HelloWorldTeraByte/MOSSbp-Jetson-Nano-Board/README.md

# MOSSbp-Jetson-Nano-Board
MOSSbp(Multi-material Open Source Secure Bio Printer) is an IoT connected bio printer. This is a daughter board for the jetson nano.
