HelloWorldTeraByte/MOSSbp-Jetson-Nano-Board/MOSSbp_Jetson_Nano_Board/MOSSbp_Jetson_Nano_Board.kicad_pcb

## KiCad design MOSSbp_Jetson_Nano_Board/MOSSbp_Jetson_Nano_Board.kicad_pcb (2020-01-27)

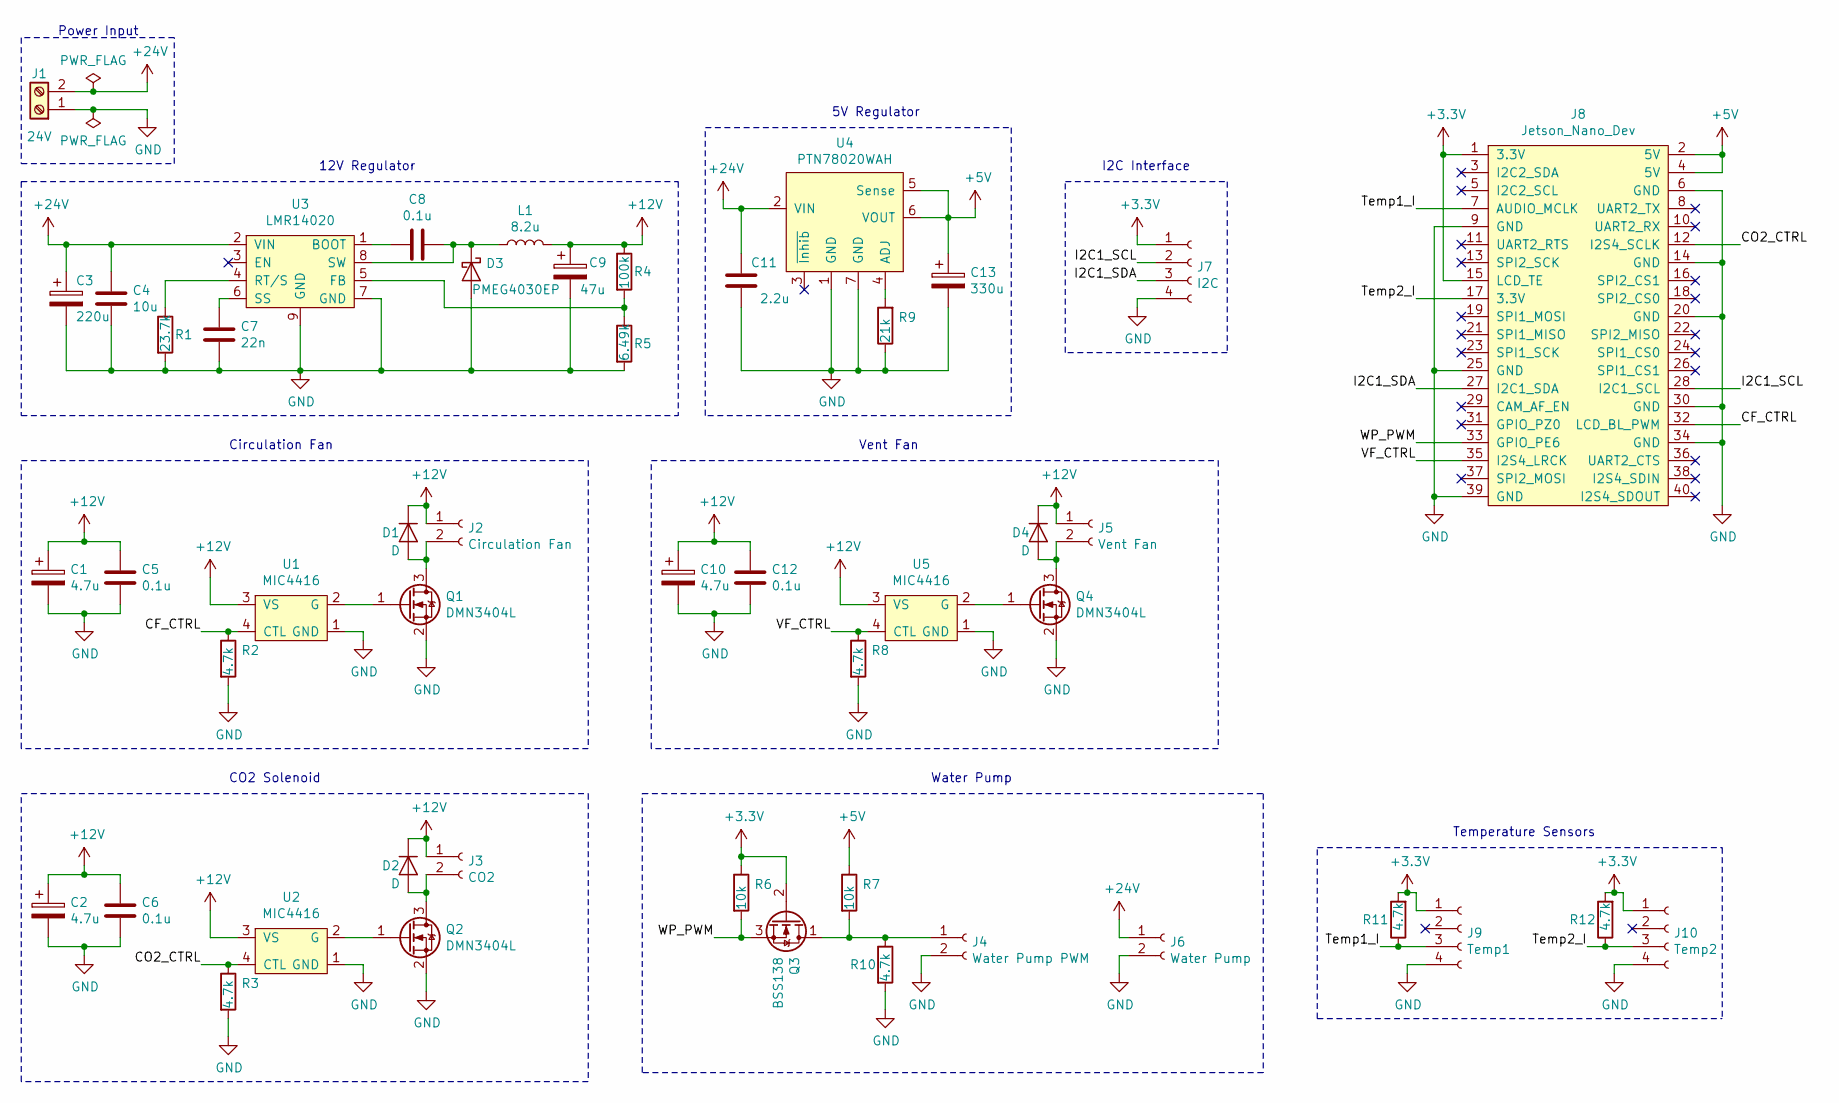
[picture p1: schematic MOSSbp_Jetson_Nano_Board.sch, MOSSbp Jetson Nano Hat]

Parts:
C1, C2, C10: 4.7u; C_1206_3216Metric_Pad1.42x1.75mm_HandSolder; Digi-Key_PN 478-11461-1-ND
C3: 220u; CP_Elec_8x10.5; Digi-Key_PN PCE5025CT-ND
C4: 10u; C_1206_3216Metric_Pad1.42x1.75mm_HandSolder; Digi-Key_PN 1276-6767-1-ND
C5, C6, C12: 0.1u; C_0603_1608Metric_Pad1.05x0.95mm_HandSolder; Digi-Key_PN 399-7845-1-ND
C7: 22n; C_0603_1608Metric_Pad1.05x0.95mm_HandSolder; Digi-Key_PN 399-3476-1-ND
C8: 0.1u; C_0603_1608Metric_Pad1.05x0.95mm_HandSolder; Digi-Key_PN 311-1341-1-ND
C9: 47u; C_2220_5650Metric_Pad1.97x5.40mm_HandSolder; Digi-Key_PN 445-7935-1-ND
C11: 2.2u; C_0603_1608Metric_Pad1.05x0.95mm_HandSolder; Digi-Key_PN 490-10486-1-ND
C13: 330u; CP_Elec_8x10; Digi-Key_PN PCE3888CT-ND
D1, D2, D4: D; D_SOD-123; Digi-Key_PN MBR130T1GOSDKR-ND
D3: PMEG4030EP; D_SOD-128; Digi-Key_PN 1727-5841-1-ND
J1: 24V; TerminalBlock_Phoenix_MKDS-1,5-2_1x02_P5.00mm_Horizontal; Digi-Key_PN 277-1667-ND
J2: Circulation Fan; JST_GH_BM02B-GHS-TBT_1x02-1MP_P1.25mm_Vertical; Digi-Key_PN 455-1578-1-ND
J3: CO2; JST_GH_BM02B-GHS-TBT_1x02-1MP_P1.25mm_Vertical; Digi-Key_PN 455-1578-1-ND
J4: Water Pump PWM; JST_GH_BM02B-GHS-TBT_1x02-1MP_P1.25mm_Vertical; Digi-Key_PN 455-1578-1-ND
J5: Vent Fan; JST_GH_BM02B-GHS-TBT_1x02-1MP_P1.25mm_Vertical; Digi-Key_PN 455-1578-1-ND
J6: Water Pump; JST_XH_B2B-XH-AM_1x02_P2.50mm_Vertical; Digi-Key_PN 455-2247-ND
J7: I2C; JST_GH_BM04B-GHS-TBT_1x04-1MP_P1.25mm_Vertical; Digi-Key_PN 455-1580-1-ND
J8: Jetson_Nano_Dev; PinHeader_2x20_P2.54mm_Vertical
J9: Temp1; JST_GH_BM04B-GHS-TBT_1x04-1MP_P1.25mm_Vertical; Digi-Key_PN 455-1580-1-ND
J10: Temp2; JST_GH_BM04B-GHS-TBT_1x04-1MP_P1.25mm_Vertical; Digi-Key_PN 455-1580-1-ND
L1: 8.2u; SRN8040-8R2Y; Digi-Key_PN SRN8040-8R2YCT-ND
Q1, Q2, Q4: DMN3404L; SOT-23; Digi-Key_PN DMN3404LDICT-ND
Q3: BSS138; SOT-23; Digi-Key_PN BSS138CT-ND
R1: 23.7k; R_0603_1608Metric_Pad1.05x0.95mm_HandSolder; Digi-Key_PN P23.7KHCT-ND
R2, R3, R8, R10, R11, R12: 4.7k; R_0603_1608Metric_Pad1.05x0.95mm_HandSolder; Digi-Key_PN 311-4.7KGRCT-ND
R4: 100k; R_0603_1608Metric_Pad1.05x0.95mm_HandSolder; Digi-Key_PN P100KDBCT-ND
R5: 6.49k; R_0603_1608Metric_Pad1.05x0.95mm_HandSolder; Digi-Key_PN P20065CT-ND
R6, R7: 10k; R_0603_1608Metric_Pad1.05x0.95mm_HandSolder; Digi-Key_PN 311-10.0KHRCT-ND
R9: 21k; R_0603_1608Metric_Pad1.05x0.95mm_HandSolder; Digi-Key_PN P21.0KHCT-ND
U1, U2, U5: MIC4416; SOT-143; Digi-Key_PN 576-1187-1-ND
U3: LMR14020; SOIC-8-1EP_3.9x4.9mm_P1.27mm_EP2.41x3.3mm; Digi-Key_PN 296-44320-1-ND
U4: PTN78020WAH; Digi-Key_PN 296-20515-ND

Connections:
+3V3: J7.1, J8.1 (3.3V), J8.15 (LCD_TE), J9.1, J10.1, Q3.2 (G), R6.1, R11.2, R12.2
+5V: C13.1, J8.2 (5V), J8.4 (5V), R7.1, U4.5 (Sense), U4.6 (VOUT)
+12V: C1.1, C2.1, C5.1, C6.1, C9.1, C10.1, C12.1, D1.1 (K), D2.1 (K), D4.1 (K), J2.1, J3.1, J5.1, L1.2, R4.1, U1.3 (VS), U2.3 (VS), U5.3 (VS)
+24V: C3.1, C4.1, C11.1, J1.2, J6.1, U3.2 (VIN), U4.2 (VIN)
/CF_CTRL: J8.32 (LCD_BL_PWM), R2.1, U1.4 (CTL)
/CO2_CTRL: J8.12 (I2S4_SCLK), R3.1, U2.4 (CTL)
/I2C1_SCL: J7.2, J8.28 (I2C1_SCL)
/I2C1_SDA: J7.3, J8.27 (I2C1_SDA)
/Temp1_I: J8.7 (AUDIO_MCLK), J9.3, R11.1
/Temp2_I: J8.17 (3.3V), J10.3, R12.1
/VF_CTRL: J8.35 (I2S4_LRCK), R8.1, U5.4 (CTL)
/WP_PWM: J8.33 (GPIO_PE6), Q3.3 (S), R6.2
GND: C1.2, C2.2, C3.2, C4.2, C5.2, C6.2, C7.2, C9.2, C10.2, C11.2, C12.2, C13.2, D3.2 (A), J1.1, J4.2, J6.2, J7.4, J8.6 (GND), J8.9 (GND), J8.14 (GND), J8.20 (GND), J8.25 (GND), J8.30 (GND), J8.34 (GND), J8.39 (GND), J9.4, J10.4, Q1.2 (S), Q2.2 (S), Q4.2 (S), R1.2, R2.2, R3.2, R5.2, R8.2, R9.1, R10.2, U1.1 (GND), U2.1 (GND), U3.7 (GND), U3.9 (GND), U4.1 (GND), U4.7 (GND), U5.1 (GND)
unnamed: C7.1, U3.6 (SS)
unnamed: C8.1, D3.1 (K), L1.1, U3.8 (SW)
unnamed: C8.2, U3.1 (BOOT)
unnamed: D1.2 (A), J2.2, Q1.3 (D)
unnamed: D2.2 (A), J3.2, Q2.3 (D)
unnamed: D4.2 (A), J5.2, Q4.3 (D)
unnamed: J4.1, Q3.1 (D), R7.2, R10.1
unnamed: Q1.1 (G), U1.2 (G)
unnamed: Q2.1 (G), U2.2 (G)
unnamed: Q4.1 (G), U5.2 (G)
unnamed: R1.1, U3.4 (RT/S)
unnamed: R4.2, R5.1, U3.5 (FB)
unnamed: R9.2, U4.4 (ADJ)

Notes on the sheet:
12V Regulator
Power Input
Circulation Fan
Vent Fan
CO2 Solenoid
Water Pump
5V Regulator
I2C Interface
Temperature Sensors

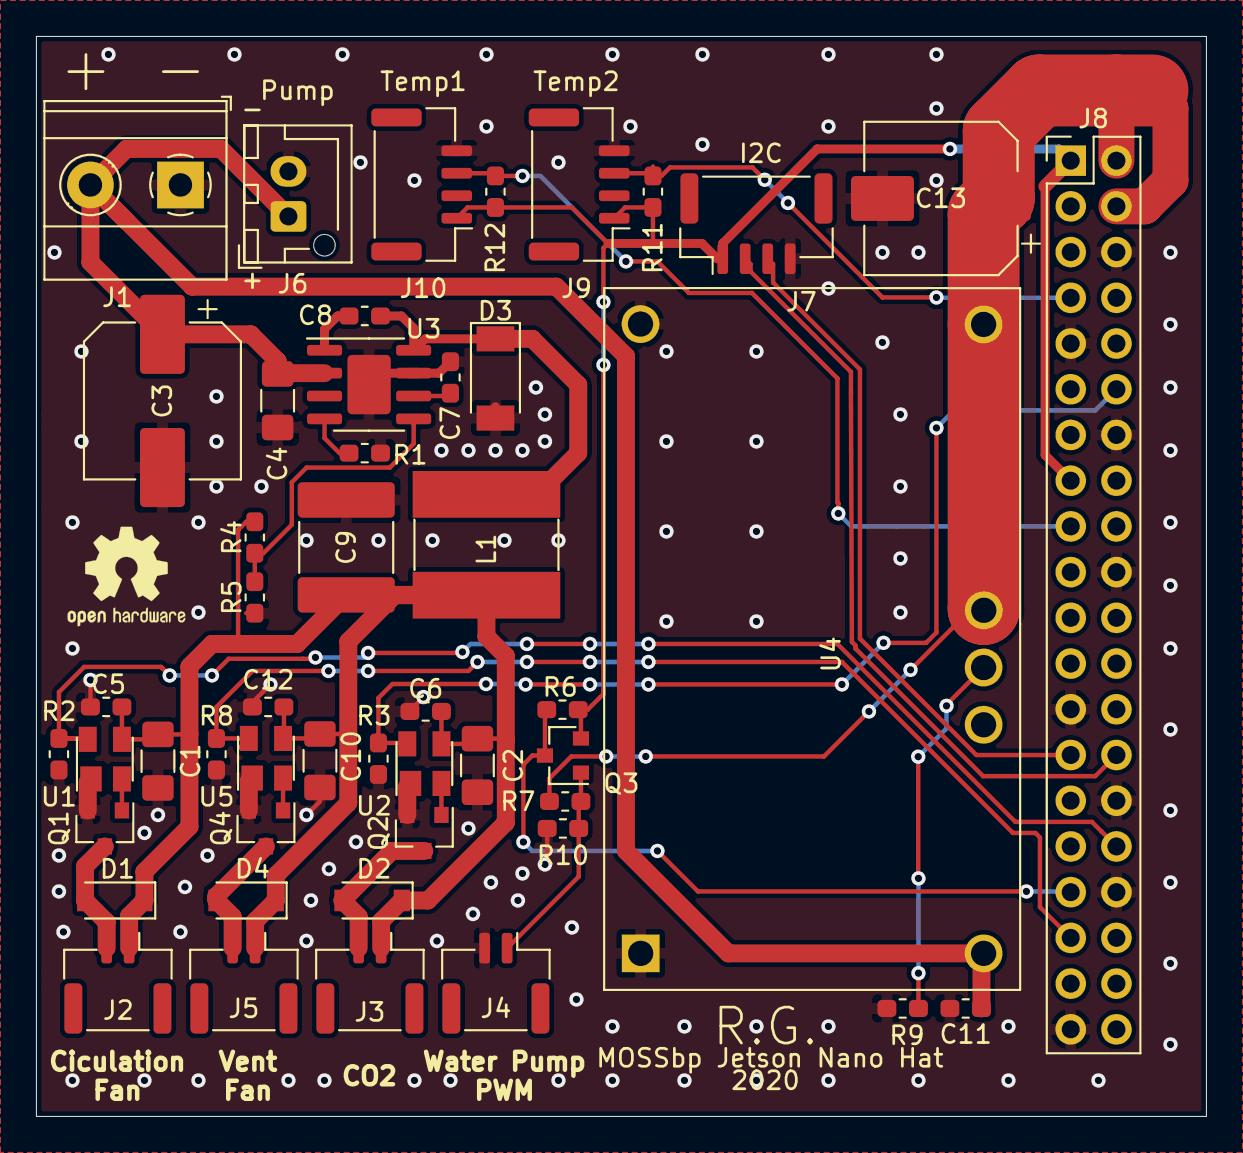
[picture p2: board MOSSbp_Jetson_Nano_Board.kicad_pcb from above]

Board: 2 copper layers, 65.0 x 60.0 mm, 49 parts (0 on the bottom side), 26 nets.
