HelloWorldTeraByte/MOSSbp-Jetson-Nano-Board/(commit log)

2019-12-31 Inital commit of PCB design
    [MOSSbp_Jetson_Nano_Board.kicad_pcb, MOSSbp_Jetson_Nano_Board.sch]
2020-01-15 Added 5V Regulator
    [MOSSbp_Jetson_Nano_Board.sch]
2020-01-21 Changed the symbol library name
    [MOSSbp_Jetson_Nano_Board.sch]
2020-01-23 Added fans and pump controls
    [MOSSbp_Jetson_Nano_Board.sch]
2020-01-23 Added 5V regulator and control pins
    [MOSSbp_Jetson_Nano_Board.sch]
2020-01-24 Added I2C interface and assigned parts
    [MOSSbp_Jetson_Nano_Board.sch]
2020-01-24 Added footprint associations
    [MOSSbp_Jetson_Nano_Board.sch]
2020-01-26 Finished assigning footprints and part numbers
    [MOSSbp_Jetson_Nano_Board.sch]
2020-01-26 Started PCB design
    [MOSSbp_Jetson_Nano_Board.kicad_pcb, MOSSbp_Jetson_Nano_Board.sch]
2020-01-27 Finished PCB routing
    [MOSSbp_Jetson_Nano_Board-B_Cu.gbr, MOSSbp_Jetson_Nano_Board-B_Mask.gbr, MOSSbp_Jetson_Nano_Board-B_Paste.gbr, MOSSbp_Jetson_Nano_Board-B_SilkS.gbr, MOSSbp_Jetson_Nano_Board-Edge_Cuts.gbr, MOSSbp_Jetson_Nano_Board-F_Cu.gbr, MOSSbp_Jetson_Nano_Board-F_Mask.gbr, MOSSbp_Jetson_Nano_Board-F_Paste.gbr]
2020-01-27 Adding temperature sensors
    [MOSSbp_Jetson_Nano_Board.kicad_pcb, MOSSbp_Jetson_Nano_Board.sch]
2020-01-27 Finished adding temp sensors
    [MOSSbp_Jetson_Nano_Board-B_Cu.gbr, MOSSbp_Jetson_Nano_Board-B_Mask.gbr, MOSSbp_Jetson_Nano_Board-B_Paste.gbr, MOSSbp_Jetson_Nano_Board-B_SilkS.gbr, MOSSbp_Jetson_Nano_Board-Edge_Cuts.gbr, MOSSbp_Jetson_Nano_Board-F_Cu.gbr, MOSSbp_Jetson_Nano_Board-F_Mask.gbr, MOSSbp_Jetson_Nano_Board-F_Paste.gbr]
